FAB1150/ESP32_fan_control/pwm_fan_control/pwm_fan_control.ino

#include <math.h>

//uncomment if you want serial output (temperature  measured_voltage  resistance  dutyCycle)
  //#define DEBUG

//setting the I/O pins
  //the fan PWM output pin
    const int fanOutput = 32;
  //thermistor pin
    const int thrm = 25;

//settings for the fan curve
  //comment if you want the fans to spin at the minimum speed (minDutyCycle) instead of turning off
    #define FAN_OFF
  //minimum temperature that makes the fan spin
    const int MINTEMP = 35;
  //the minimum PWM duty cycle is when the fan just starts to spin. 40 is about right for most fans. Set it even if you use FAN_OFF as it's used in the fan curve calculation!
    const int minDutyCycle = 40;
    
  //maximum fan speed, from 0 to 255 (63 is 25%, 127 is 50%, 190 is 75%)
    const int maxDutyCycle = 190; 
  
  //select the fan curve you want to use. Only uncomment one!
    //#define CURVE_EXP //exponential curve. Use for temperatures from 15 to 30C
    //#define CURVE_TIMESTWO //Use for temperatures up to 125C, gentler slope
    //#define CURVE_TIMESTHREE //Use for temperatures up to 85C, more aggressive
    #define CURVE_SIGMOID //approximation of a sigmoid curve. It's a ramp that starts climbing from MINTEMP and caps off at MAXTEMP, with the fan speed at maxDutyCycle
      const int MAXTEMP = 60; //only for the sigmoid curve - described in the README file

//variables for the thermistor resistance calculation
  const float V_OFFSET = 0.1; //offset between the readings and the actual voltage input, because the esp32 ADC is garbage. Documented in the README
  const float Vcc = 3.3; //voltage reference of the voltage divider
  const float R_1 = 100000.0; //resistance in Ohms of the first resistor in the voltage divider (2nd resistor is the thermistor)
  const float R_Tk = 100000.0; //resistance in Ohms of the thermistor at 25°C (nominal resistance)
  const float BCoeff = 3950.0; //B coefficient of the thermistor (the numbers in the name of the thermistor - NTC xxxx 100K)
  const int averaging = 70; //how many readings we average to spit out a value, higher is slower but more stable

//initializing our duty cycle variable
  int dutyCycle = 0;

//PWM properties (for fans, a 25khz frequency is needed). No need to edit this
  const int freq = 25000;
  const int ledChannel = 0;
  const int resolution = 8;

void setup() {
  
  //setting the ledc channel up with the settings
  ledcSetup(ledChannel, freq, resolution);
  //attaching the ledc channel to the output pin
  ledcAttachPin(fanOutput, ledChannel);

  #ifdef DEBUG
    //initiate the serial connection to tell the values to the computer
    Serial.begin(115200);
    delay(1000);
  #endif
}

void loop(){
  //getting the temperature, and voltage + resistance for debugging
  float temperature = getTemp(averaging , true);
  #ifdef DEBUG
    float voltage = getVoltage(averaging);
    float resistance = getResistance(averaging);
    Serial.print(temperature);
    Serial.print("   ");
    Serial.print(voltage);
    Serial.print("   ");
    Serial.print(resistance/1000);
    Serial.print("K");
  #endif

  //controlling the fan speed with the temperature
    //using a fan curve
    #ifdef CURVE_EXP
      dutyCycle = pow(temperature - 15, 2);
    #endif
    #ifdef CURVE_TIMESTWO
      dutyCycle = temperature * 2;
    #endif
    #ifdef CURVE_TIMESTHREE
      dutyCycle = temperature * 3;
    #endif
    #ifdef CURVE_SIGMOID
      dutyCycle = (((temperature - MINTEMP)/(MAXTEMP - MINTEMP))*(maxDutyCycle - minDutyCycle)) + minDutyCycle;
    #endif

    //if the duty cycle is under minDutyCycle, set it to minDutyCycle (doesn't turn the fan off)
    if(dutyCycle <= minDutyCycle){
      dutyCycle = minDutyCycle;
    }
    #ifdef FAN_OFF
      //if the temperature is under minTemp, turn off the fan. Only active if FAN_OFF is defined in the settings
      if(temperature <= MINTEMP){
        dutyCycle = 0;
      }
    #endif
    
    //cap the duty cycle to MaxDutyCycle
    if(dutyCycle > maxDutyCycle){
        dutyCycle = maxDutyCycle;
      }
      
    //check if the PWM dutycycle is inside the bounds
    if(dutyCycle < 0){
      dutyCycle = 0;
    }
    if(dutyCycle > 255){
      dutyCycle = 255;
    }
    
    //send the PWM to the fan, writing on serial for debugging
    ledcWrite(ledChannel, dutyCycle);
    #ifdef DEBUG
      Serial.print("   ");
      Serial.println(dutyCycle);
    #endif

  //wait a bit between repeating all the checks
  delay(50);
}

float getTemp(int avg_size , bool Celsius) {
  //we can approximate the temperature of the thermistor with the B-parameter equation
  float resistance = getResistance(avg_size);
  //getting the approximated temperature in Kelvin, then getting C out of it
  float TempK = 1.0 /((log(resistance / R_Tk)/BCoeff) + (1 / 298.5));
  float Temp = TempK - 273.15;

  if(Celsius){
    return Temp;
  }else{
    return TempK;
  }
}

float getVoltage(int avg_size){
  float V_sum = 0.0;
  for(int i=0 ; i<avg_size ; i++){
    //reading the thermistor value
    int thrmValue = analogRead(thrm);
    //converting it to a voltage (imperfect, the ESP32 has a non-linear ADC, and summing the values together
    float thrmVoltage = ((thrmValue/4095.0)*Vcc) + V_OFFSET;
    V_sum += thrmVoltage;
  }
  //dividing the sum of the readings to get the average
  float V_approx = V_sum / float(avg_size);

  //returning the voltage reading. Because of the offset there could be weird readings at the extremes, that are eliminated
  if(V_approx <= 0.0){
    return 0.0;
  }else if(V_approx > Vcc){
    return Vcc;
  }else{ //if(V_approx <= Vcc) and more than 0V, everything is OK
    return V_approx;
  }
}

float getResistance(int avg_size){
  //getting a voltage reading
  float V_0 = getVoltage(avg_size);
  //converting the voltage into a resistance since R1 is known
  float resistance = (V_0 * R_1)/(Vcc - V_0);

  return resistance;
}
