FAB1150/ESP32_fan_control/(commit log)

2022-06-14 added the voltage regulator image
2022-06-27 added an image to illustrate the fan curve
2022-06-27 fixed the default thermistor values
    [pwm_fan_control.ino]
2022-06-30 updated readme and added image for thermistor calibration
2022-06-30 fixed the voltage check
    [pwm_fan_control.ino]
2022-06-30 added images for the voltage compensation
